adaptive-intelligent-robotics/Qutee_v2/README.md

# Qutee_v2
Repository for the base code and design of the Qutee V2 robot
