adaptive-intelligent-robotics/Qutee_v2/hardware/docs/photos/Image.jpeg

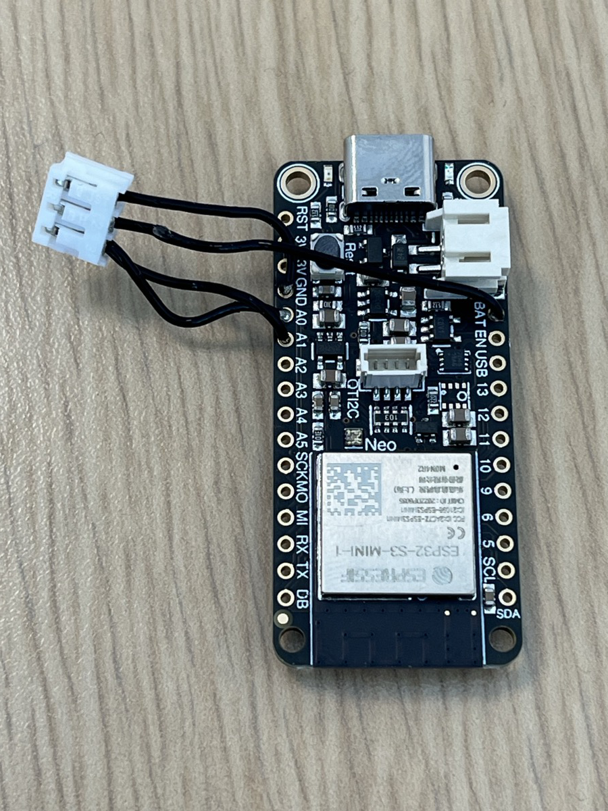
hardware/docs/photos/Image.jpeg
