adaptive-intelligent-robotics/Qutee_v2/hardware/STL/full_fdm_plate_mk3.9.3mf

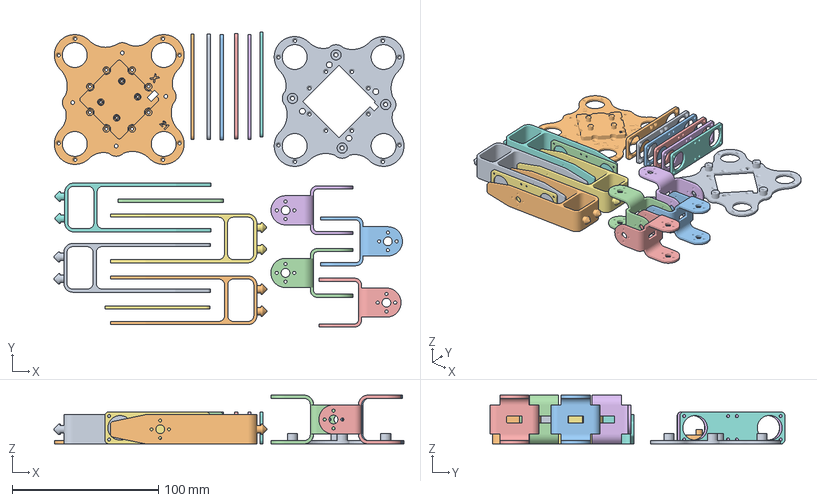
[picture p5: CAD file, 2024-02-29]
hardware/STL/full_fdm_plate_mk3.9.3mf
239.4 x 201.8 x 33.4 mm
body_base v17.stl
body_bottom v24.stl
doubleU v9.stl
side v8.stl
tibia v21.stl
