adaptive-intelligent-robotics/Qutee_v2/hardware/STL/doubleU v9.stl

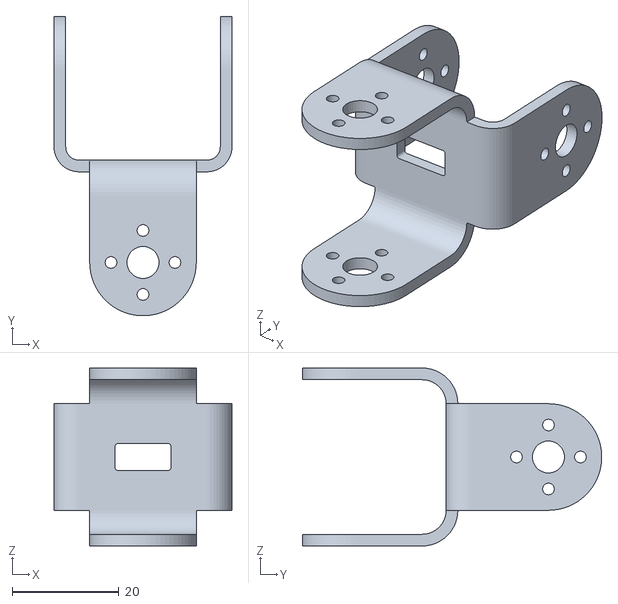
[picture p6: CAD file, 2024-01-12]
hardware/STL/doubleU v9.stl
33.4 x 56.2 x 33.4
