adaptive-intelligent-robotics/Qutee_v2/hardware/STL/Case_tft v19.stl

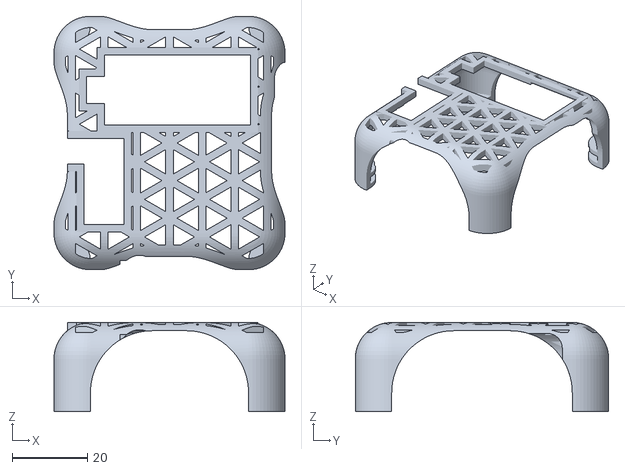
[picture p7: CAD file, 2023-09-12]
hardware/STL/Case_tft v19.stl
61.5 x 67.4 x 23.7
