adaptive-intelligent-robotics/Qutee_v2/hardware/STL/body_bottom v24.stl

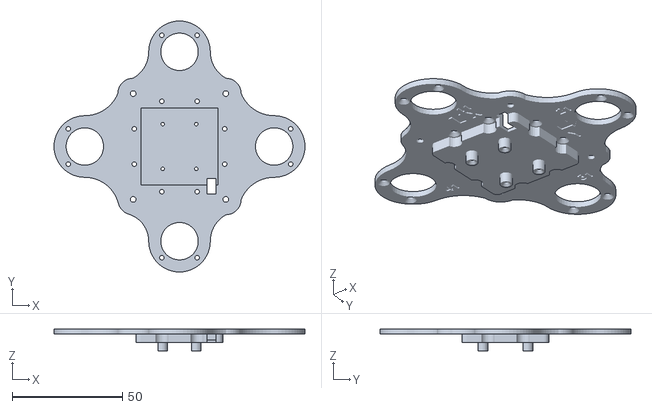
[picture p8: CAD file, 2023-09-07]
hardware/STL/body_bottom v24.stl
114.0 x 114.0 x 9.80
