adaptive-intelligent-robotics/Qutee_v2/hardware/STL/spacer_for_tft v39.stl

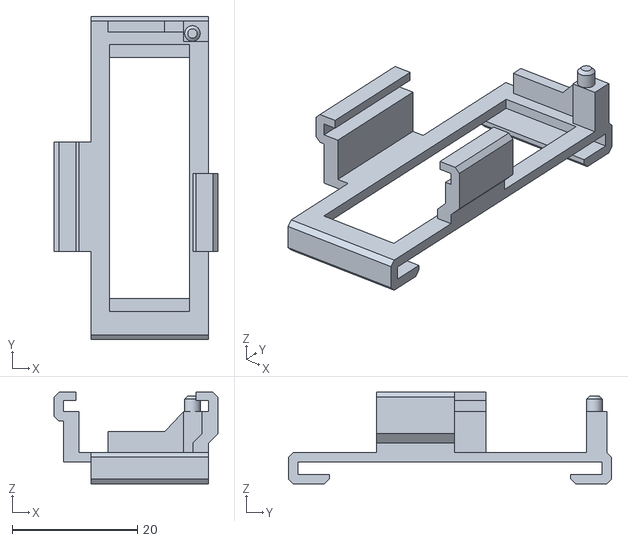
[picture p9: CAD file, 2023-09-07]
hardware/STL/spacer_for_tft v39.stl
26.1 x 51.5 x 14.6
