adaptive-intelligent-robotics/Qutee_v2/hardware/STL/spacer_no_tft v15.stl

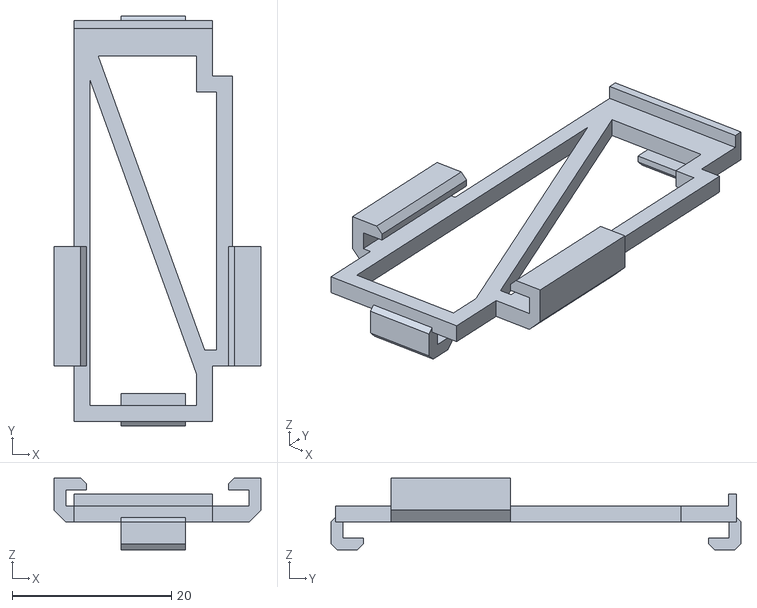
[picture p10: CAD file, 2023-09-02]
hardware/STL/spacer_no_tft v15.stl
26.0 x 51.5 x 9.00
