adaptive-intelligent-robotics/Qutee_v2/hardware/STL/Case_no_tft v2.stl

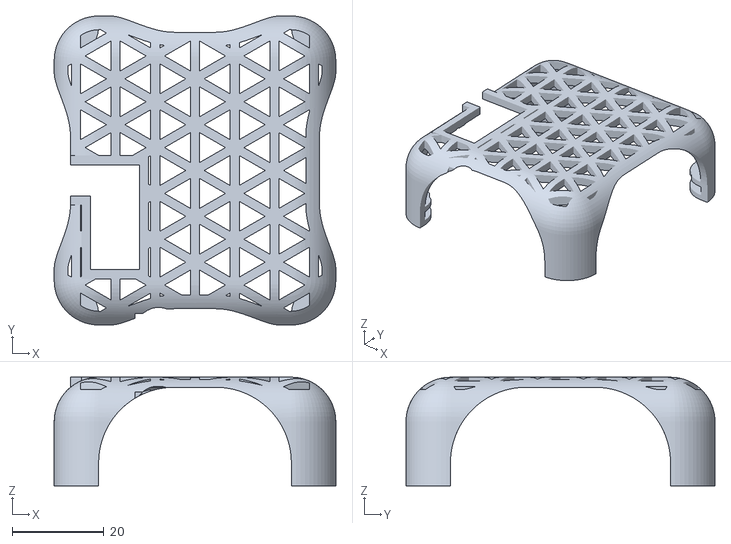
[picture p11: CAD file, 2023-09-02]
hardware/STL/Case_no_tft v2.stl
61.5 x 67.4 x 23.7
