adaptive-intelligent-robotics/Qutee_v2/hardware/STL/horn_spacer v2.stl

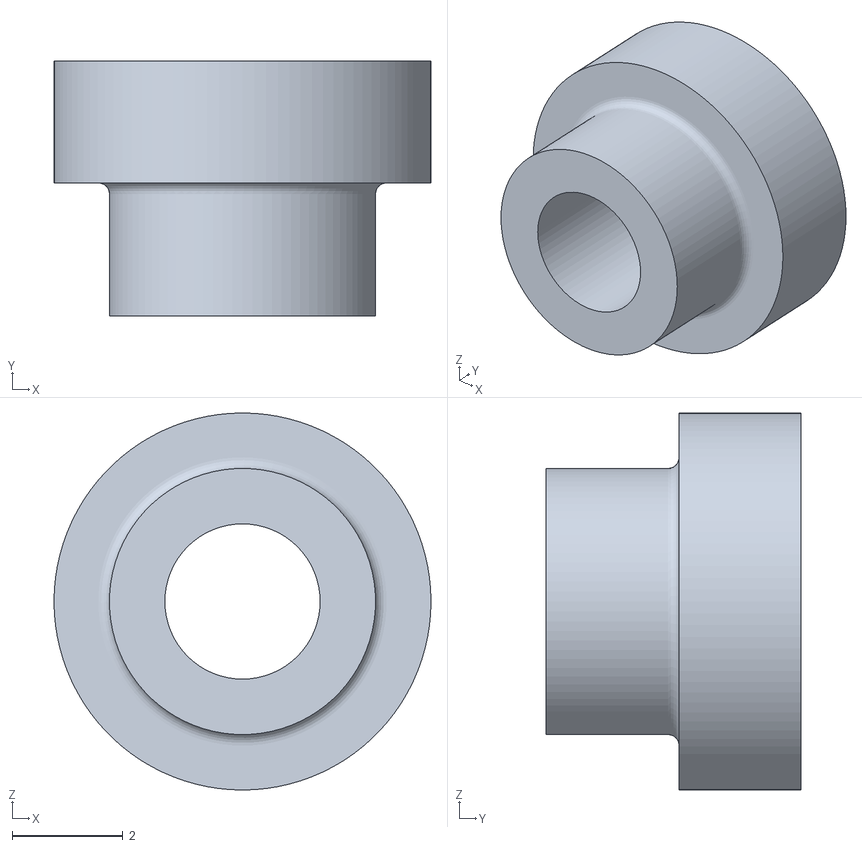
[picture p12: CAD file, 2023-08-30]
hardware/STL/horn_spacer v2.stl
6.80 x 4.60 x 6.80
