adaptive-intelligent-robotics/Qutee_v2/hardware/STL/horn v1.stl

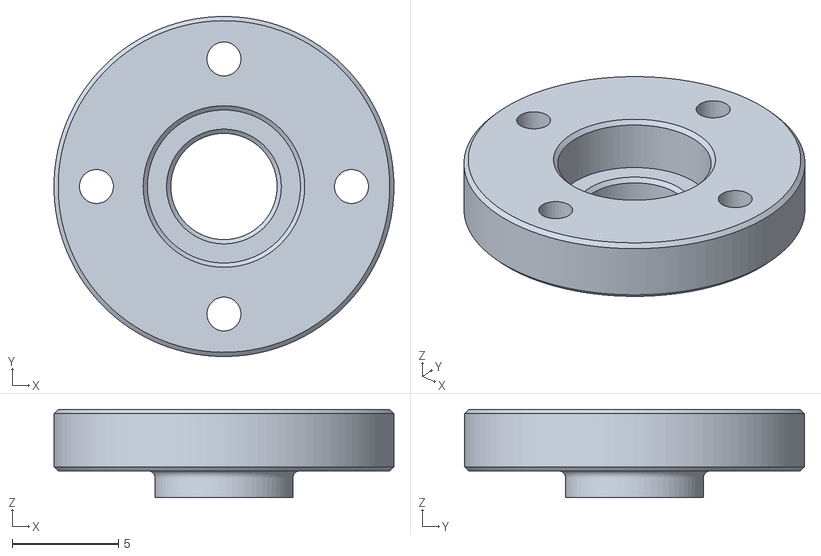
[picture p13: CAD file, 2023-08-30]
hardware/STL/horn v1.stl
16.0 x 16.0 x 4.15
