adaptive-intelligent-robotics/Qutee_v2/hardware/STL/foot v20.stl

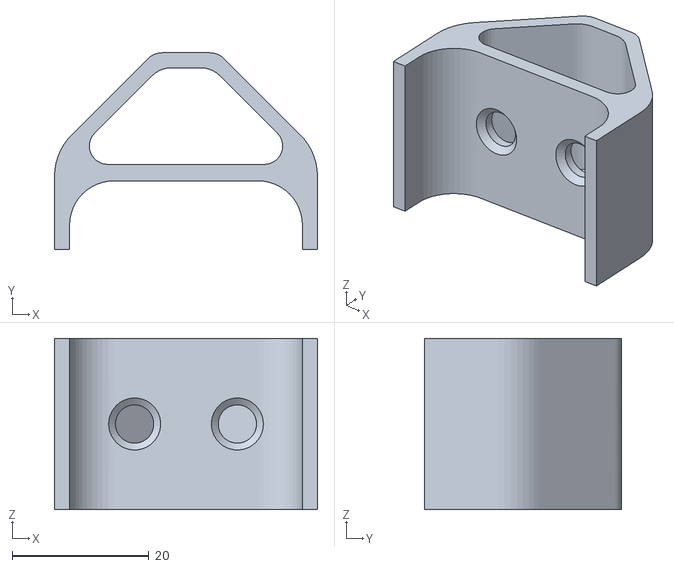
[picture p14: CAD file, 2023-08-30]
hardware/STL/foot v20.stl
38.4 x 28.7 x 25.0
