adaptive-intelligent-robotics/Qutee_v2/hardware/STL/case_bottom v3.stl

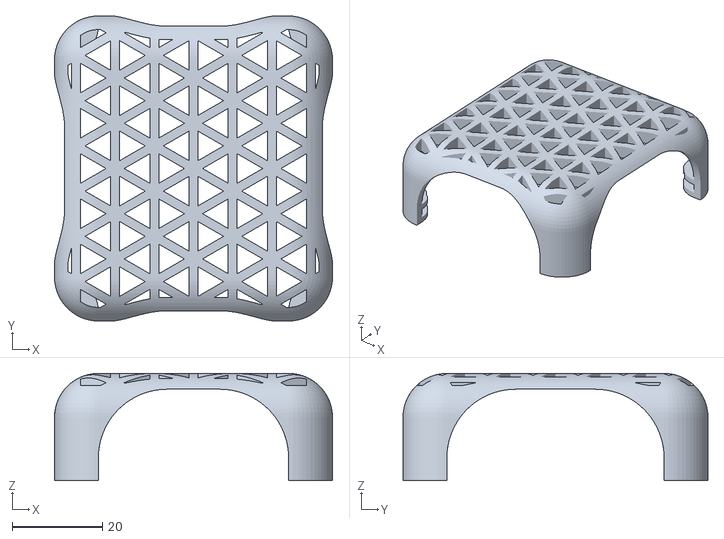
[picture p15: CAD file, 2023-08-30]
hardware/STL/case_bottom v3.stl
61.5 x 67.4 x 23.7
