adaptive-intelligent-robotics/Qutee_v2/hardware/STL/tibia v21.stl

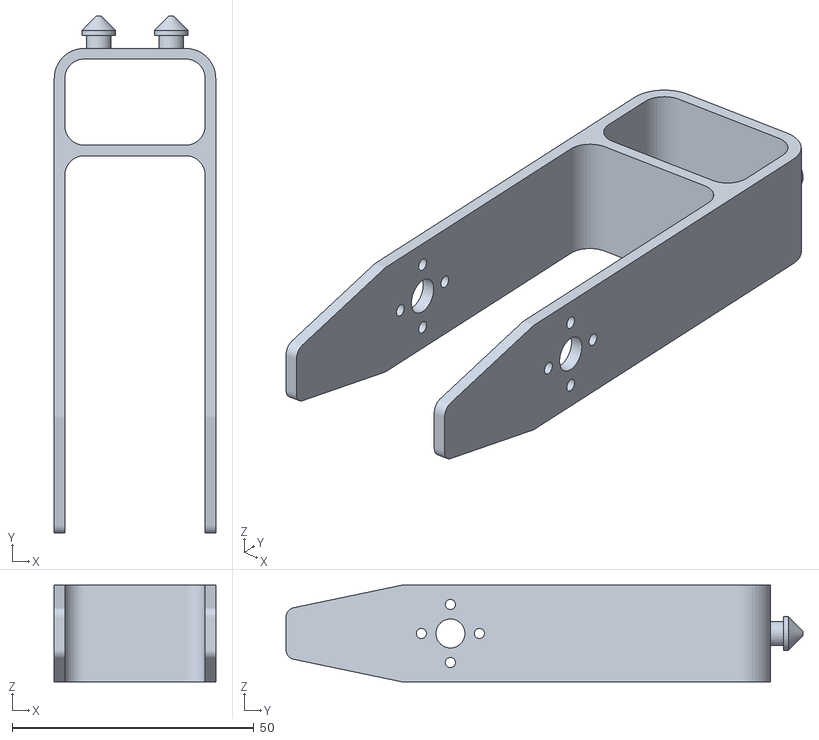
[picture p16: CAD file, 2023-08-30]
hardware/STL/tibia v21.stl
33.4 x 106.9 x 20.0
