adaptive-intelligent-robotics/Qutee_v2/hardware/STL/side v8.stl

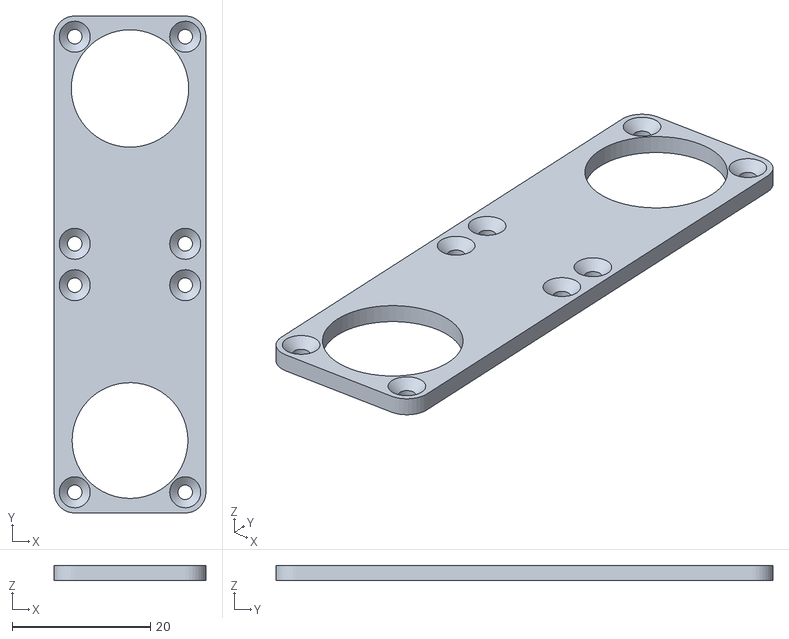
[picture p17: CAD file, 2023-08-30]
hardware/STL/side v8.stl
22.0 x 72.0 x 2.20
