adaptive-intelligent-robotics/Qutee_v2/hardware/STL/body_base v17.stl

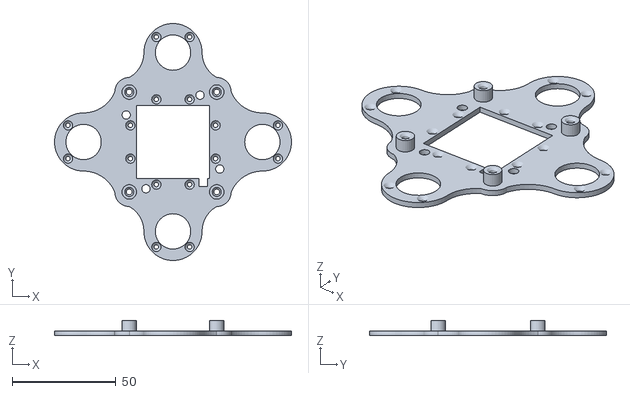
[picture p18: CAD file, 2023-08-30]
hardware/STL/body_base v17.stl
114.0 x 114.0 x 7.20
