adaptive-intelligent-robotics/Qutee_v2/(threads)

Thread 1 (2024-02-05):

Docker Software Compilation Issue

zin-lin, 2024-02-05:
Dear Developers, we are a group of students from Edinburgh Napier University researching on the Qutee robot. We would like to know how to compile the right way. We have followed the instructions on the software Readme.md. Pulling those docker images worked perfectly well, but when compiling from idf.py build inside the docker, it won't build the project. It has a couple of potential version problems for the CMakeList. Even changing the version still doesn't work with certain libraries like arduino missing. For your information we have also pull all the submodules and still doesn't work. The problems we encounters are esp32s3 component missing, arduino component missing. The Esp IDF, says we don't need those libraries but we don't know if we need esp_ipc and esp_hid components that are missing. Please guide us on how to build this with idf.py build inside the docker and how the entry point is accessed the right way. If this is the issue that is needed to be solved we are willing to help with what we can.

Aneoshun, 2024-02-13:
Hi,
I will do my best to help. I found that the overall ESP IDF configuration quite troublesome to set up properly, but that was the only way I found to get a proper compilation environment. (note: using arduino-IDF is not possible as we need to change the registry config in the ESP32 to enable half-duplex uart for the dynamixels).

I am pretty sure that you need the esp32s3 component. Otherwise, the IDF won't know the characteristics of the board.
You can change the board target, and hopefully trigger an install of the library, by pressing the button at the bottom of the IDF which says "ESP32S3" in the following screenshot.
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

It will help me if you can list step by step what you did, and what are the error messages on your end. I will try to reproduce this on my side and guide you.

zin-lin, 2024-02-13:
Firstly, we follow throught with
```shell
docker run -it --rm --user espidf --volume="/etc/timezone:/etc/timezone:ro" -v $(pwd):/micro_ros_espidf_component -v /dev:/dev --privileged --workdir /micro_ros_espidf_component microros/esp-idf-microros:foxy /bin/bash```
command in my shell. Then we ran idf.py build. Are wew missing some steps. We also pulled all the submodules
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
This is the problem we are encountering, so I have to change it to esp32 which is included in the components. but not esp32s3. This is our first error, I will update you with the next step after we know how to solve this. Thanks again

Aneoshun, 2024-02-13:
Did you try to do "idf.py menuconfig" first? If yes, how did it go and were you able to change the target?

zin-lin, 2024-02-13:
Thanks, I will get back to you, I think I need to install the esp32s3 locally as the target, I will do that now. Thanks again

zin-lin, 2024-02-13:
Dear @Aneoshun, do we need to plug ESP32s3 in to test the code? I cannot get the component, and when I open the project on VSCode I cannot set the targe, I might not have set up the project right. I will first look into what I should do with it and I will get back to you tomorrow and update my situation. Again thank you very much for the help.

Aneoshun, 2024-02-14:
No, you don't need the hardware module to compile the code. You only need the module when you want to flash it, which happens in a separate stage after the compilation.

zin-lin, 2024-02-14:
I see. As I have not work with Cpp for such project, usually I use python I might be missing some set up features for the project. Is the editor you have used VSCode or VS22. I would like to know how to set up the project with the board target. I have tried and failed. Can you kindly guide us through that. Thanks

Aneoshun, 2024-02-21:
Hi,
I decided to re-work the entire build process to make it simpler. Now everything can be done via terminal (you don't need vscode, or any IDE).
I also created a custom docker container to use directly the right esp-idf version.

Could you please follow the new instructions and let me know if you have any issue:  https://github.com/adaptive-intelligent-robotics/Qutee_v2/tree/main/software

Thanks.

zin-lin, 2024-02-26:
Thanks again for the response. I still have an error
```shell
In file included from /micro_ros_espidf_component/main/Qutee.cpp:1:
/micro_ros_espidf_component/main/Qutee.hpp:15:10: fatal error: arduino.h: No such file or directory
   15 | #include "arduino.h"
      |          ^~~~~~~~~~~
compilation terminated.

```

But esp32s3 can be done now. I don't know where this error comes from. I can build it for target esp32s3 outside the docker when installing the esp-idf platform onto my ubuntu terminal. but still the same problem.

zin-lin, 2024-02-26:
Ok I have found the issue. In your code in the main/Qutee.hpp while using Arduino feature the import written was
```c++
#include "arduino.h" // original version
#include "Arduino.h" // corrected
``` once we do this then we can build and Qutee.bin is there. With this I would like to thank you again for your time. and I will go ahead and close this.

Closed 2024-02-26.

Thread 2 (2024-11-16):

Ninja fails as it can't find static library

artificialsimon, 2024-11-16:
Hi,

I'm trying to build the Qutee V2 firmware using the guidelines from the software readme.
After building the docker image, I can run it in interactive mode. However, when I try to build with idf.py build I get several errors, some of them go away by trying to build a couple of extra times. Then I need to manually create micro_ros_espidf_component/main/include dir to continue. After that, I get this error:

```
-- Build files have been written to: /micro_ros_espidf_component/build
[0/2] Re-checking globbed directories...ninja: error: '/micro_ros_espidf_component/main/libquteeinterface.a', needed by 'QuteeV2.elf', missing and no known rule to make it
ninja failed with exit code 1, output of the command is in the /micro_ros_espidf_component/build/log/idf_py_stderr_output_10822 and /micro_ros_espidf_component/build/log/idf_py_stdout_output_10822
```

I tried removing all the files as the readme indicates, also doing a full clean with idf.py to no avail.
I'm on ubuntu 22.04. Trying to build with defaults, so I haven't run idf.py menuconfig.

Thank you,
Simon

I'm adding the full log:

```
espidf@5e0881f57138:/micro_ros_espidf_component$ idf.py build
Executing action: all (aliases: build)
Running cmake in directory /micro_ros_espidf_component/build
Executing "cmake -G Ninja -DPYTHON_DEPS_CHECKED=1 -DPYTHON=/opt/esp/python_env/idf5.1_py3.8_env/bin/python -DESP_PLATFORM=1 -DCCACHE_ENABLE=1 /micro_ros_espidf_component"...
-- IDF_TARGET is not set, guessed 'esp32s3' from sdkconfig '/micro_ros_espidf_component/sdkconfig'
-- Found Git: /usr/bin/git (found version "2.25.1")
-- Component directory /micro_ros_espidf_component/components/Adafruit-ST7735-Library does not contain a CMakeLists.txt file. No component will be added
-- Component directory /micro_ros_espidf_component/components/Adafruit_BNO055 does not contain a CMakeLists.txt file. No component will be added
-- Component directory /micro_ros_espidf_component/components/Adafruit_MAX1704X does not contain a CMakeLists.txt file. No component will be added
-- Component directory /micro_ros_espidf_component/components/Adafruit_Seesaw does not contain a CMakeLists.txt file. No component will be added
-- Component directory /micro_ros_espidf_component/components/Adafruit_Sensor does not contain a CMakeLists.txt file. No component will be added
-- Component directory /micro_ros_espidf_component/components/Dynamixel2Arduino does not contain a CMakeLists.txt file. No component will be added
-- ccache will be used for faster recompilation
-- The C compiler identification is GNU 12.2.0
-- The CXX compiler identification is GNU 12.2.0
-- The ASM compiler identification is GNU
-- Found assembler: /opt/esp/tools/xtensa-esp32s3-elf/esp-12.2.0_20230208/xtensa-esp32s3-elf/bin/xtensa-esp32s3-elf-gcc
-- Detecting C compiler ABI info
-- Detecting C compiler ABI info - done
-- Check for working C compiler: /opt/esp/tools/xtensa-esp32s3-elf/esp-12.2.0_20230208/xtensa-esp32s3-elf/bin/xtensa-esp32s3-elf-gcc - skipped
-- Detecting C compile features
-- Detecting C compile features - done
-- Detecting CXX compiler ABI info
-- Detecting CXX compiler ABI info - done
-- Check for working CXX compiler: /opt/esp/tools/xtensa-esp32s3-elf/esp-12.2.0_20230208/xtensa-esp32s3-elf/bin/xtensa-esp32s3-elf-g++ - skipped
-- Detecting CXX compile features
-- Detecting CXX compile features - done
-- git rev-parse returned 'fatal: not a git repository (or any parent up to mount point /)
Stopping at filesystem boundary (GIT_DISCOVERY_ACROSS_FILESYSTEM not set).'
-- Could not use 'git describe' to determine PROJECT_VER.
-- Building ESP-IDF components for target esp32s3
NOTICE:
Following dependencies have new versions available:
Dependency "espressif/esp-dsp": "1.5.2" -> "1.4.12"
Dependency "espressif/esp-sr": "1.6.1" -> "1.9.4"
Dependency "espressif/esp-zboss-lib": "1.1.1" -> "1.6.0"
Dependency "espressif/esp-zigbee-lib": "1.1.1" -> "1.6.0"
Dependency "espressif/esp_diagnostics": "1.0.2" -> "1.2.1"
Dependency "espressif/esp_insights": "1.0.1" -> "1.2.2"
Dependency "espressif/esp_rainmaker": "1.1.0" -> "1.5.1"
Dependency "espressif/esp_schedule": "1.1.1" -> "1.2.0"
Dependency "joltwallet/littlefs": "1.14.1" -> "1.14.8"
Consider running "idf.py update-dependencies" to update your lock file.
Processing 21 dependencies:
[1/21] chmorgan/esp-libhelix-mp3 (1.0.3)
[2/21] espressif/cbor (0.6.0~1)
[3/21] espressif/eigen (3.4.0~2)
[4/21] espressif/esp-dsp (1.5.2)
[5/21] espressif/esp-sr (1.6.1)
[6/21] espressif/esp-zboss-lib (1.1.1)
[7/21] espressif/esp-zigbee-lib (1.1.1)
[8/21] espressif/esp_diag_data_store (1.0.2)
[9/21] espressif/esp_diagnostics (1.0.2)
[10/21] espressif/esp_insights (1.0.1)
[11/21] espressif/esp_rainmaker (1.1.0)
[12/21] espressif/esp_schedule (1.1.1)
[13/21] espressif/esp_secure_cert_mgr (2.5.0)
[14/21] espressif/jsmn (1.1.0)
[15/21] espressif/json_generator (1.1.2)
[16/21] espressif/json_parser (1.0.3)
[17/21] espressif/mdns (1.2.1)
[18/21] espressif/qrcode (0.1.0~2)
[19/21] espressif/rmaker_common (1.4.6)
[20/21] joltwallet/littlefs (1.14.1)
[21/21] idf (5.1.5)
-- Using Micro XRCE-DDS middleware
mkdir -p /micro_ros_espidf_component/main//libquteeinterface; cd /micro_ros_espidf_component/main//libquteeinterface; \
for file in $(find /micro_ros_espidf_component/main//install/lib/ -name '*.a'); do \
	folder=$(echo $file | sed -E "s/(.+)\/(.+).a/\2/"); \
	mkdir -p $folder; cd $folder;  x $file; \
	for f in *; do \
		mv $f ../$folder-$f; \
	done; \
	cd ..; rm -rf $folder; \
done ; \
 rc -s libquteeinterface.a *.obj; cp libquteeinterface.a /micro_ros_espidf_component/main/; \
cd ..; rm -rf libquteeinterface; \
cp -R /micro_ros_espidf_component/main//install/include /micro_ros_espidf_component/main//include;
-- Project sdkconfig file /micro_ros_espidf_component/sdkconfig
Loading defaults file /micro_ros_espidf_component/sdkconfig.defaults...
Compiler supported targets: xtensa-esp32s3-elf

-- Looking for sys/types.h
-- Looking for sys/types.h - found
-- Looking for stdint.h
-- Looking for stdint.h - found
-- Looking for stddef.h
-- Looking for stddef.h - found
-- Check size of time_t
-- Check size of time_t - done
-- Found Python3: /opt/esp/python_env/idf5.1_py3.8_env/bin/python (found version "3.8.10") found components: Interpreter
-- Performing Test CMAKE_HAVE_LIBC_PTHREAD
-- Performing Test CMAKE_HAVE_LIBC_PTHREAD - Failed
-- Check if compiler accepts -pthread
-- Check if compiler accepts -pthread - no
-- Looking for pthread_create in pthreads
-- Looking for pthread_create in pthreads - not found
-- Looking for pthread_create in pthread
-- Looking for pthread_create in pthread - not found
-- Could NOT find Threads (missing: Threads_FOUND)
-- Performing Test C_COMPILER_SUPPORTS_WFORMAT_SIGNEDNESS
-- Performing Test C_COMPILER_SUPPORTS_WFORMAT_SIGNEDNESS - Success
-- App "QuteeV2" version: 1
-- Adding linker script /micro_ros_espidf_component/build/esp-idf/esp_system/ld/memory.ld
-- Adding linker script /opt/esp/idf/components/esp_system/ld/esp32s3/sections.ld.in
-- Adding linker script /opt/esp/idf/components/esp_rom/esp32s3/ld/esp32s3.rom.ld
-- Adding linker script /opt/esp/idf/components/esp_rom/esp32s3/ld/esp32s3.rom.api.ld
-- Adding linker script /opt/esp/idf/components/esp_rom/esp32s3/ld/esp32s3.rom.libgcc.ld
-- Adding linker script /opt/esp/idf/components/esp_rom/esp32s3/ld/esp32s3.rom.newlib.ld
-- Adding linker script /opt/esp/idf/components/esp_rom/esp32s3/ld/esp32s3.rom.version.ld
-- Adding linker script /opt/esp/idf/components/soc/esp32s3/ld/esp32s3.peripherals.ld
fatal: detected dubious ownership in repository at '/opt/esp/idf/components/openthread/openthread'
To add an exception for this directory, call:

	git config --global --add safe.directory /opt/esp/idf/components/openthread/openthread
-- git rev-parse returned 'fatal: not a git repository (or any parent up to mount point /)
Stopping at filesystem boundary (GIT_DISCOVERY_ACROSS_FILESYSTEM not set).'
ESP Insights Project commit: HEAD-HASH-NOTFOUND
-- git rev-parse returned 'fatal: not a git repository (or any parent up to mount point /)
Stopping at filesystem boundary (GIT_DISCOVERY_ACROSS_FILESYSTEM not set).'
ESP RainMaker Project commit: HEAD-HASH-NOTFOUND
-- Using Micro XRCE-DDS middleware
mkdir -p /micro_ros_espidf_component/components/micro_ros_espidf_component/micro_ros_src/libmicroros; cd /micro_ros_espidf_component/components/micro_ros_espidf_component/micro_ros_src/libmicroros; \
for file in $(find /micro_ros_espidf_component/components/micro_ros_espidf_component/micro_ros_src/install/lib/ -name '*.a'); do \
	folder=$(echo $file | sed -E "s/(.+)\/(.+).a/\2/"); \
	mkdir -p $folder; cd $folder; /opt/esp/tools/xtensa-esp32s3-elf/esp-12.2.0_20230208/xtensa-esp32s3-elf/bin/xtensa-esp32s3-elf-ar x $file; \
	for f in *; do \
		mv $f ../$folder-$f; \
	done; \
	cd ..; rm -rf $folder; \
done ; \
/opt/esp/tools/xtensa-esp32s3-elf/esp-12.2.0_20230208/xtensa-esp32s3-elf/bin/xtensa-esp32s3-elf-ar rc -s libmicroros.a *.obj; cp libmicroros.a /micro_ros_espidf_component/components/micro_ros_espidf_component; \
cd ..; rm -rf libmicroros; \
cp -R /micro_ros_espidf_component/components/micro_ros_espidf_component/micro_ros_src/install/include /micro_ros_espidf_component/components/micro_ros_espidf_component/include;
-- Using Micro XRCE-DDS middleware
[AUTHOR_WARNING]BLA BLA lsit: xtensa
[AUTHOR_WARNING]BLA BLA lsit: esp_ringbuf
[AUTHOR_WARNING]BLA BLA lsit: efuse
[AUTHOR_WARNING]BLA BLA lsit: driver
[AUTHOR_WARNING]BLA BLA lsit: esp_pm
[AUTHOR_WARNING]BLA BLA lsit: mbedtls
[AUTHOR_WARNING]BLA BLA lsit: esp_app_format
[AUTHOR_WARNING]BLA BLA lsit: bootloader_support
[AUTHOR_WARNING]BLA BLA lsit: bootloader
[AUTHOR_WARNING]BLA BLA lsit: esptool_py
[AUTHOR_WARNING]BLA BLA lsit: partition_table
[AUTHOR_WARNING]BLA BLA lsit: esp_partition
[AUTHOR_WARNING]BLA BLA lsit: app_update
[AUTHOR_WARNING]BLA BLA lsit: esp_mm
[AUTHOR_WARNING]BLA BLA lsit: spi_flash
[AUTHOR_WARNING]BLA BLA lsit: pthread
[AUTHOR_WARNING]BLA BLA lsit: esp_system
[AUTHOR_WARNING]BLA BLA lsit: esp_rom
[AUTHOR_WARNING]BLA BLA lsit: hal
[AUTHOR_WARNING]BLA BLA lsit: log
[AUTHOR_WARNING]BLA BLA lsit: heap
[AUTHOR_WARNING]BLA BLA lsit: soc
[AUTHOR_WARNING]BLA BLA lsit: esp_hw_support
[AUTHOR_WARNING]BLA BLA lsit: freertos
[AUTHOR_WARNING]BLA BLA lsit: newlib
[AUTHOR_WARNING]BLA BLA lsit: cxx
[AUTHOR_WARNING]BLA BLA lsit: esp_common
[AUTHOR_WARNING]BLA BLA lsit: esp_timer
[AUTHOR_WARNING]BLA BLA lsit: app_trace
[AUTHOR_WARNING]BLA BLA lsit: esp_event
[AUTHOR_WARNING]BLA BLA lsit: nvs_flash
[AUTHOR_WARNING]BLA BLA lsit: esp_phy
[AUTHOR_WARNING]BLA BLA lsit: vfs
[AUTHOR_WARNING]BLA BLA lsit: lwip
[AUTHOR_WARNING]BLA BLA lsit: esp_netif_stack
[AUTHOR_WARNING]BLA BLA lsit: esp_netif
[AUTHOR_WARNING]BLA BLA lsit: wpa_supplicant
[AUTHOR_WARNING]BLA BLA lsit: esp_coex
[AUTHOR_WARNING]BLA BLA lsit: esp_wifi
[AUTHOR_WARNING]BLA BLA lsit: bt
[AUTHOR_WARNING]BLA BLA lsit: unity
[AUTHOR_WARNING]BLA BLA lsit: cmock
[AUTHOR_WARNING]BLA BLA lsit: console
[AUTHOR_WARNING]BLA BLA lsit: http_parser
[AUTHOR_WARNING]BLA BLA lsit: esp-tls
[AUTHOR_WARNING]BLA BLA lsit: esp_adc
[AUTHOR_WARNING]BLA BLA lsit: esp_eth
[AUTHOR_WARNING]BLA BLA lsit: esp_gdbstub
[AUTHOR_WARNING]BLA BLA lsit: esp_hid
[AUTHOR_WARNING]BLA BLA lsit: tcp_transport
[AUTHOR_WARNING]BLA BLA lsit: esp_http_client
[AUTHOR_WARNING]BLA BLA lsit: esp_http_server
[AUTHOR_WARNING]BLA BLA lsit: esp_https_ota
[AUTHOR_WARNING]BLA BLA lsit: esp_https_server
[AUTHOR_WARNING]BLA BLA lsit: esp_psram
[AUTHOR_WARNING]BLA BLA lsit: esp_lcd
[AUTHOR_WARNING]BLA BLA lsit: protobuf-c
[AUTHOR_WARNING]BLA BLA lsit: protocomm
[AUTHOR_WARNING]BLA BLA lsit: esp_local_ctrl
[AUTHOR_WARNING]BLA BLA lsit: espcoredump
[AUTHOR_WARNING]BLA BLA lsit: wear_levelling
[AUTHOR_WARNING]BLA BLA lsit: sdmmc
[AUTHOR_WARNING]BLA BLA lsit: fatfs
[AUTHOR_WARNING]BLA BLA lsit: idf_test
[AUTHOR_WARNING]BLA BLA lsit: ieee802154
[AUTHOR_WARNING]BLA BLA lsit: json
[AUTHOR_WARNING]BLA BLA lsit: mqtt
[AUTHOR_WARNING]BLA BLA lsit: openthread
[AUTHOR_WARNING]BLA BLA lsit: perfmon
[AUTHOR_WARNING]BLA BLA lsit: spiffs
[AUTHOR_WARNING]BLA BLA lsit: touch_element
[AUTHOR_WARNING]BLA BLA lsit: ulp
[AUTHOR_WARNING]BLA BLA lsit: usb
[AUTHOR_WARNING]BLA BLA lsit: wifi_provisioning
[AUTHOR_WARNING]BLA BLA lsit: chmorgan__esp-libhelix-mp3
[AUTHOR_WARNING]BLA BLA lsit: espressif__esp-dsp
[AUTHOR_WARNING]BLA BLA lsit: espressif__esp-sr
[AUTHOR_WARNING]BLA BLA lsit: espressif__esp-zboss-lib
[AUTHOR_WARNING]BLA BLA lsit: espressif__esp-zigbee-lib
[AUTHOR_WARNING]BLA BLA lsit: espressif__rmaker_common
[AUTHOR_WARNING]BLA BLA lsit: espressif__esp_diagnostics
[AUTHOR_WARNING]BLA BLA lsit: espressif__cbor
[AUTHOR_WARNING]BLA BLA lsit: espressif__esp_diag_data_store
[AUTHOR_WARNING]BLA BLA lsit: espressif__esp_insights
[AUTHOR_WARNING]BLA BLA lsit: espressif__jsmn
[AUTHOR_WARNING]BLA BLA lsit: espressif__json_parser
[AUTHOR_WARNING]BLA BLA lsit: espressif__json_generator
[AUTHOR_WARNING]BLA BLA lsit: espressif__mdns
[AUTHOR_WARNING]BLA BLA lsit: espressif__esp_schedule
[AUTHOR_WARNING]BLA BLA lsit: espressif__esp_secure_cert_mgr
[AUTHOR_WARNING]BLA BLA lsit: espressif__esp_rainmaker
[AUTHOR_WARNING]BLA BLA lsit: espressif__qrcode
[AUTHOR_WARNING]BLA BLA lsit: joltwallet__littlefs
[AUTHOR_WARNING]BLA BLA lsit: arduino
[AUTHOR_WARNING]BLA BLA lsit: espressif__eigen
[AUTHOR_WARNING]BLA BLA lsit: micro_ros_espidf_component
[AUTHOR_WARNING]BLA BLA lsit: Adafruit_BusIO
[AUTHOR_WARNING]BLA BLA lsit: Adafruit-GFX-Library
[AUTHOR_WARNING]BLA BLA lsit: main
[AUTHOR_WARNING]BLA BLA include:  -I/opt/esp/idf/components/xtensa/include -I/opt/esp/idf/components/xtensa/esp32s3/include -I/opt/esp/idf/components/esp_ringbuf/include -I/opt/esp/idf/components/efuse/include -I/opt/esp/idf/components/efuse/esp32s3/include -I/opt/esp/idf/components/driver/include -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
mkdir -p /micro_ros_espidf_component/main//libquteeinterface; cd /micro_ros_espidf_component/main//libquteeinterface; \
for file in $(find /micro_ros_espidf_component/main//install/lib/ -name '*.a'); do \
	folder=$(echo $file | sed -E "s/(.+)\/(.+).a/\2/"); \
	mkdir -p $folder; cd $folder; /opt/esp/tools/xtensa-esp32s3-elf/esp-12.2.0_20230208/xtensa-esp32s3-elf/bin/xtensa-esp32s3-elf-ar x $file; \
	for f in *; do \
		mv $f ../$folder-$f; \
	done; \
	cd ..; rm -rf $folder; \
done ; \
/opt/esp/tools/xtensa-esp32s3-elf/esp-12.2.0_20230208/xtensa-esp32s3-elf/bin/xtensa-esp32s3-elf-ar rc -s libquteeinterface.a *.obj; cp libquteeinterface.a /micro_ros_espidf_component/main/; \
cd ..; rm -rf libquteeinterface; \
cp -R /micro_ros_espidf_component/main//install/include /micro_ros_espidf_component/main//include;
find: ‘/micro_ros_espidf_component/main//install/lib/’: No such file or directory
/opt/esp/tools/xtensa-esp32s3-elf/esp-12.2.0_20230208/xtensa-esp32s3-elf/bin/xtensa-esp32s3-elf-ar: *.obj: No such file or directory
cp: cannot stat 'libquteeinterface.a': No such file or directory
cp: cannot stat '/micro_ros_espidf_component/main//install/include': No such file or directory
make: *** [libquteeinterface.mk:51: /micro_ros_espidf_component/main//libquteeinterface.a] Error 1
--
 Properties for TARGET libquteeinterface:
   libquteeinterface.INTERFACE_INCLUDE_DIRECTORIES = "/micro_ros_espidf_component/main/include"
   libquteeinterface.INCLUDE_DIRECTORIES = <NOTFOUND>
 Properties for TARGET __idf_main:
   __idf_main.INTERFACE_INCLUDE_DIRECTORIES =
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
