adaptive-intelligent-robotics/Qutee_v2/(commit log)

2023-07-17 add submodules for IMU
2023-08-30 update hardware BoM
    [body_base v17.stl, body_bottom v17.stl, case v11.stl, case_bottom v3.stl, doubleU v8.stl, foot v20.stl, horn v1.stl, horn_spacer v2.stl]
2023-09-02 latest version of STL with TFT
    [Case_no_tft v2.stl, Case_tft v15.stl, case v11.stl, spacer v12.stl, spacer_for_tft v36.stl, spacer_no_tft v15.stl]
2023-09-07 new STL files
    [Case_tft v15.stl, Case_tft v18.stl, body_bottom v17.stl, body_bottom v24.stl, spacer_for_tft v36.stl, spacer_for_tft v39.stl]
2023-09-08 now support TFT and absolute IMU
2023-09-12 first version with custom messages
    [Case_tft v18.stl, Case_tft v19.stl]
2023-09-23 add calibration stage and adopts a sub/pub approach instead of service
2024-01-12 new version of doubleU
    [doubleU v8.stl, doubleU v9.stl]
2024-02-21 add dockerfile with esp-idf 5.2. now need to upgrade arduino-esp32 to support newer version
2024-02-21 fix new version of IDF to 5.1 and arduino-esp32 to 3.0.0.alpha
2024-02-21 fix tiny format issue in log
    [Qutee.cpp]
2024-02-22 add quick menu to either start calibration, checkup or ROS
2024-02-29 add menu, calibration tool, checkup tool, and better PID values
2024-02-29 add prusa project containing full plate of most of the pieces printed in FDM
    [full_fdm_plate_mk3.9.3mf]
2024-02-29 add prusa project containing full plate of most of the pieces printed in FDM, now with proper support
    [full_fdm_plate_mk3.9.3mf]
2024-04-04 add tools to check battery voltage
2024-04-12 fix service message structure
    [NNQuteeController.hpp, Qutee.hpp, main.cpp]
